Abdelghaffar-Elgendy/Furuta_Pendulum-/Simulink_Bodies/Submission/HIL_MCT411_T14/Actuating.png

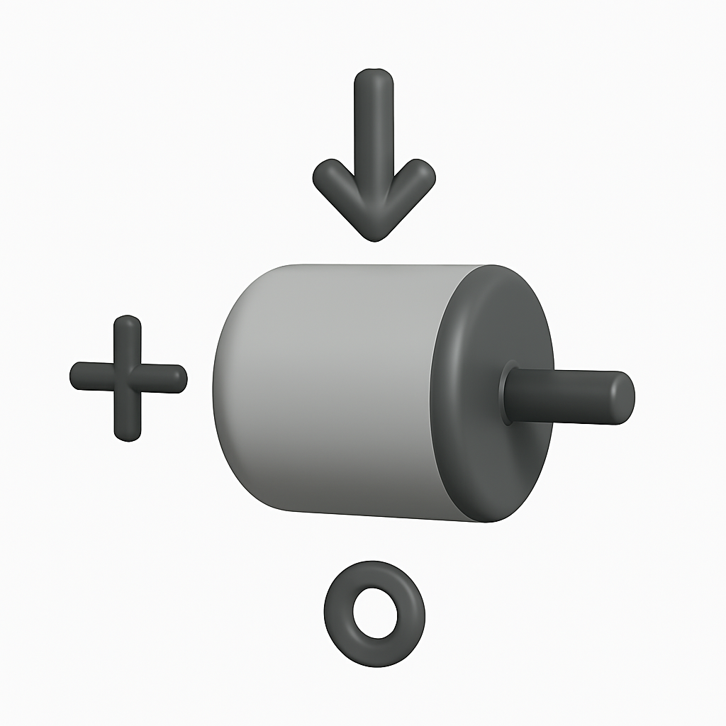
Simulink_Bodies/Submission/HIL_MCT411_T14/Actuating.png
