Abdelghaffar-Elgendy/Furuta_Pendulum-/Simulink_Bodies/Submission/CAD_T14_MCT411/Mini Rocker 4-Pin Switch.SLDPRT

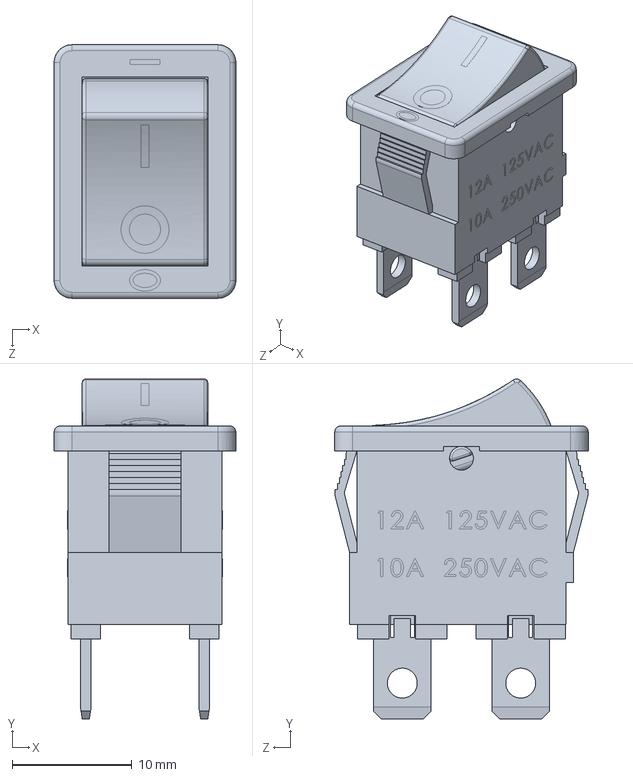
[picture p16: CAD file, 2025-12-24]
Simulink_Bodies/Submission/CAD_T14_MCT411/Mini Rocker 4-Pin Switch.SLDPRT
15.2 x 28.4 x 21.2 mm
