Abdelghaffar-Elgendy/Furuta_Pendulum-/Simulink_Bodies/Submission/Parameter_Estimation_T14/Bearing Holder_Default_sldprt.STEP

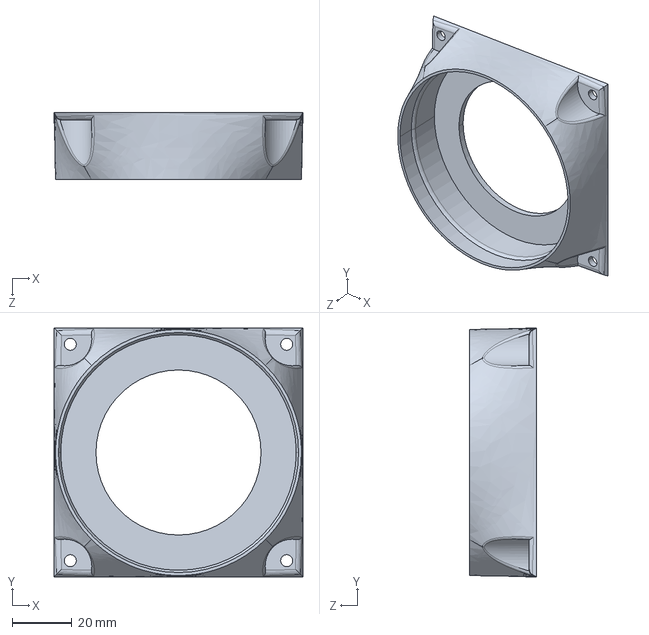
[picture p17: CAD file, 2025-12-14]
Simulink_Bodies/Submission/Parameter_Estimation_T14/Bearing Holder_Default_sldprt.STEP
83.0 x 83.0 x 22.5 mm
