Abdelghaffar-Elgendy/Furuta_Pendulum-/Simulink_Bodies/Submission/CAD_T14_MCT411/Box_sides.SLDPRT

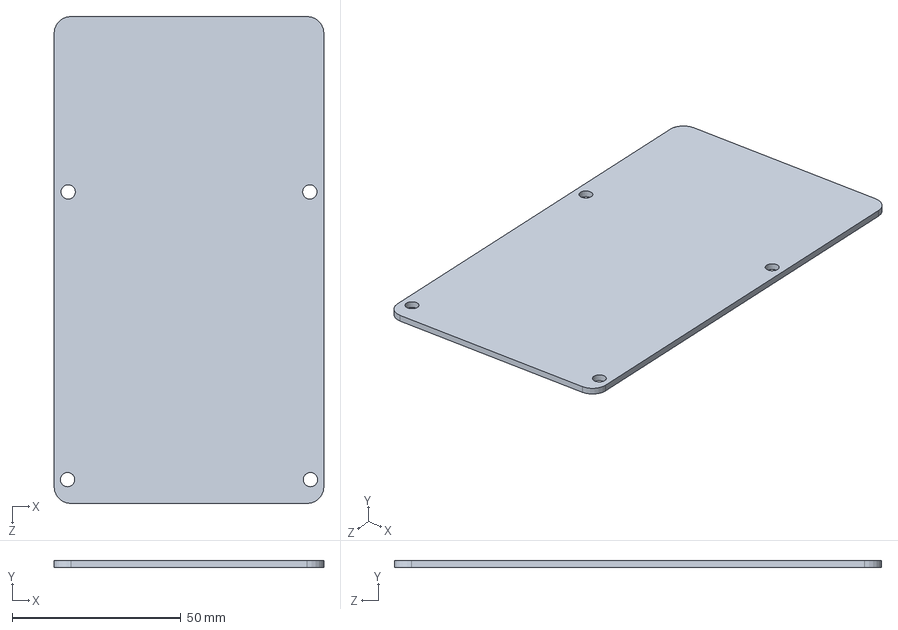
[picture p18: CAD file, 2025-12-24]
Simulink_Bodies/Submission/CAD_T14_MCT411/Box_sides.SLDPRT
80.0 x 2.00 x 144.4 mm
