Abdelghaffar-Elgendy/Furuta_Pendulum-/Simulink_Bodies/Submission/Parameter_Estimation_T14/Encoder Holder_Default_sldprt.STEP

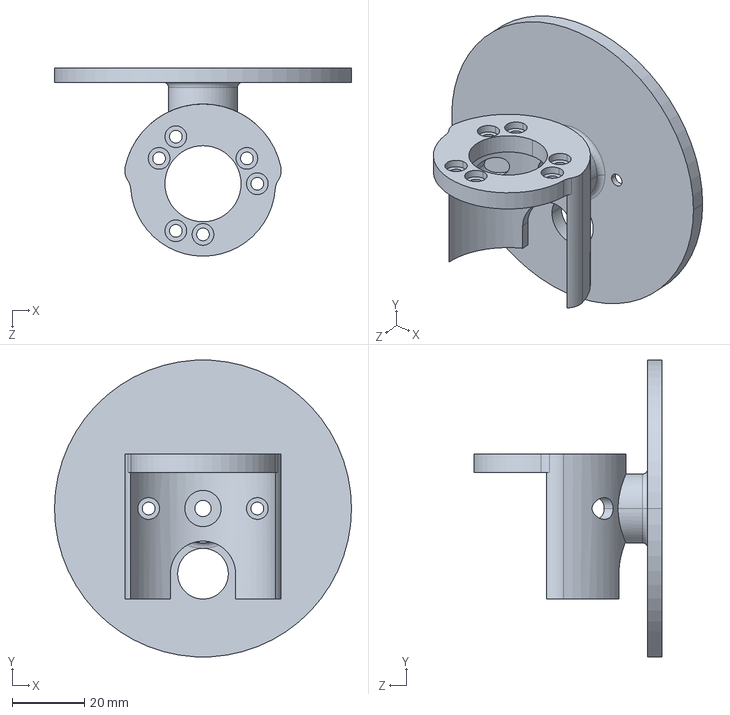
[picture p19: CAD file, 2025-12-14]
Simulink_Bodies/Submission/Parameter_Estimation_T14/Encoder Holder_Default_sldprt.STEP
82.0 x 81.9 x 52.0 mm
