Abdelghaffar-Elgendy/Furuta_Pendulum-/Simulink_Bodies/Submission/CAD_T14_MCT411/Coupler_ext.SLDPRT

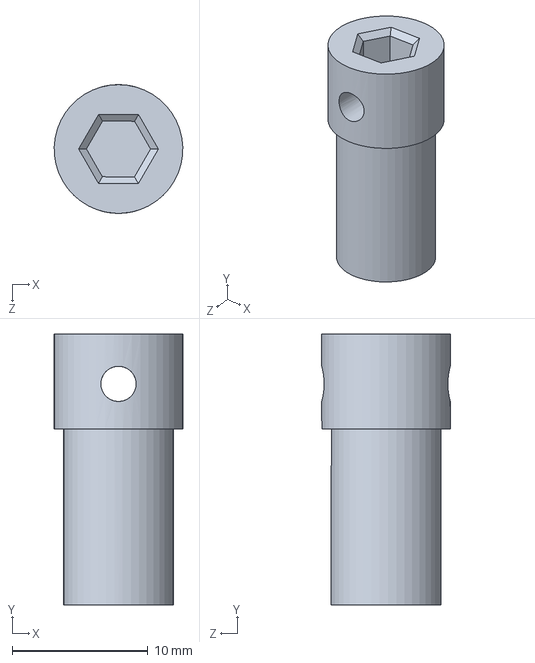
[picture p20: CAD file, 2025-12-24]
Simulink_Bodies/Submission/CAD_T14_MCT411/Coupler_ext.SLDPRT
9.49 x 20.0 x 9.50 mm
