Abdelghaffar-Elgendy/Furuta_Pendulum-/Simulink_Bodies/Submission/Parameter_Estimation_T14/coupler_Default_sldprt.STEP

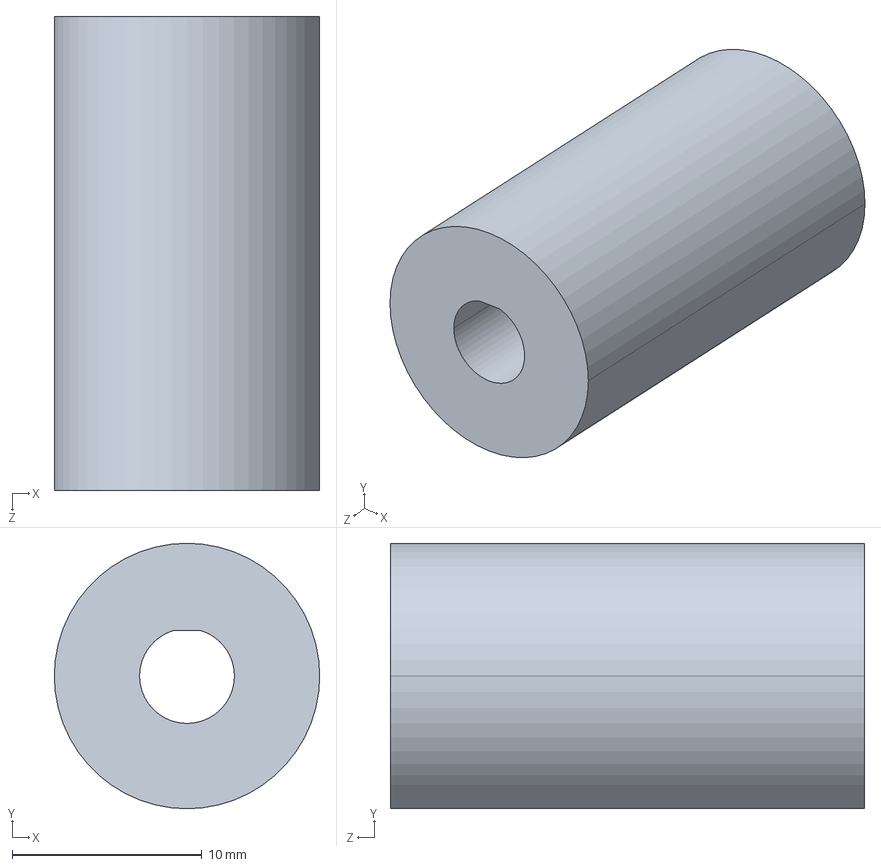
[picture p21: CAD file, 2025-12-14]
Simulink_Bodies/Submission/Parameter_Estimation_T14/coupler_Default_sldprt.STEP
14.0 x 14.0 x 25.0 mm
