Abdelghaffar-Elgendy/Furuta_Pendulum-/Simulink_Bodies/Submission/CAD_T14_MCT411/rod.SLDPRT

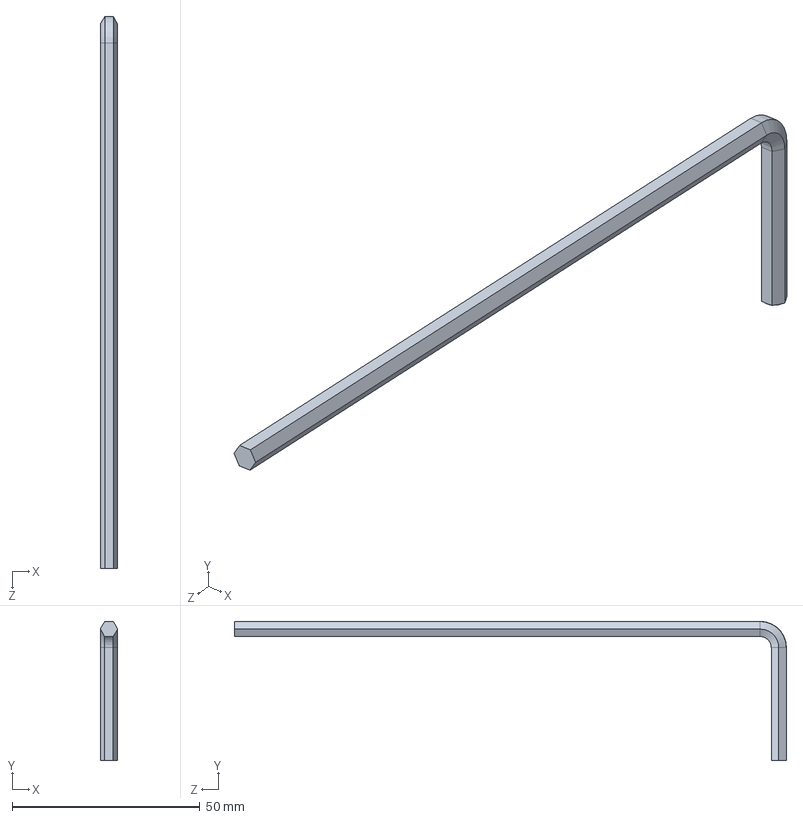
[picture p22: CAD file, 2025-12-24]
Simulink_Bodies/Submission/CAD_T14_MCT411/rod.SLDPRT
4.62 x 37.1 x 147.0 mm
