Abdelghaffar-Elgendy/Furuta_Pendulum-/Simulink_Bodies/Submission/Parameter_Estimation_T14/encoder_Default_sldprt.STEP

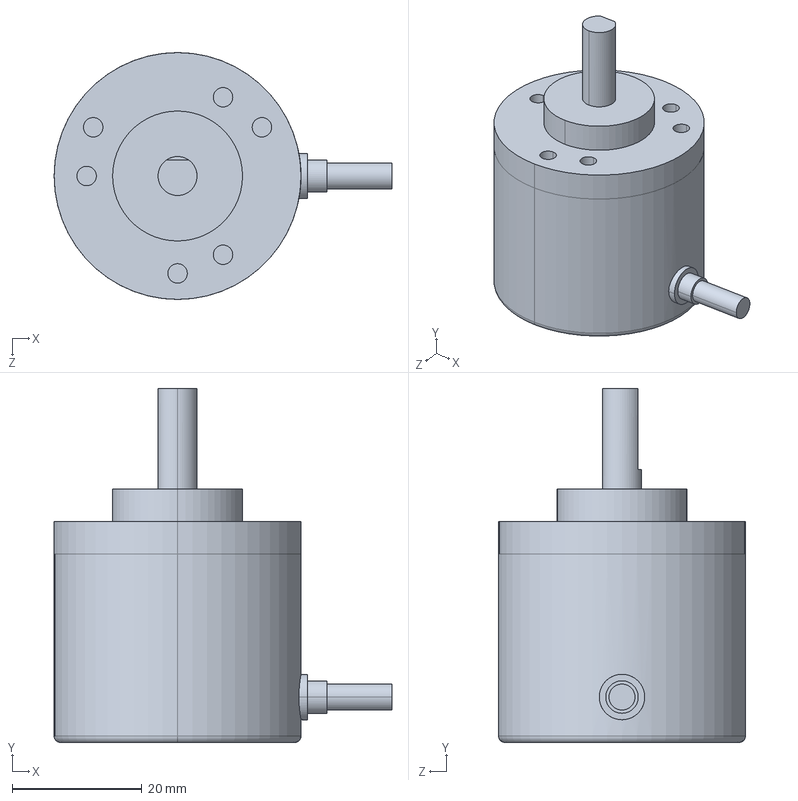
[picture p23: CAD file, 2025-12-14]
Simulink_Bodies/Submission/Parameter_Estimation_T14/encoder_Default_sldprt.STEP
52.0 x 54.5 x 38.0 mm
