Abdelghaffar-Elgendy/Furuta_Pendulum-/Simulink_Bodies/Submission/CAD_T14_MCT411/L298N Motor Driver.step

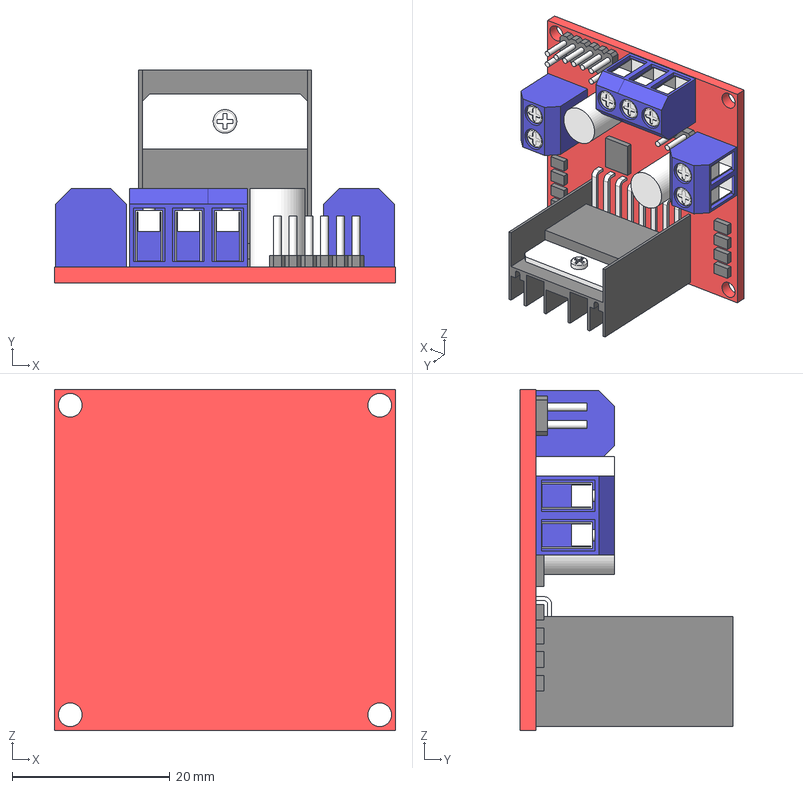
[picture p24: CAD file, 2025-12-24]
Simulink_Bodies/Submission/CAD_T14_MCT411/L298N Motor Driver.step
43.3 x 27.0 x 43.3 mm
Pcb
Pengunci x 2
Pengunci 2
