Abdelghaffar-Elgendy/Furuta_Pendulum-/Simulink_Bodies/Submission/Parameter_Estimation_T14/hexa_Default_sldprt.STEP

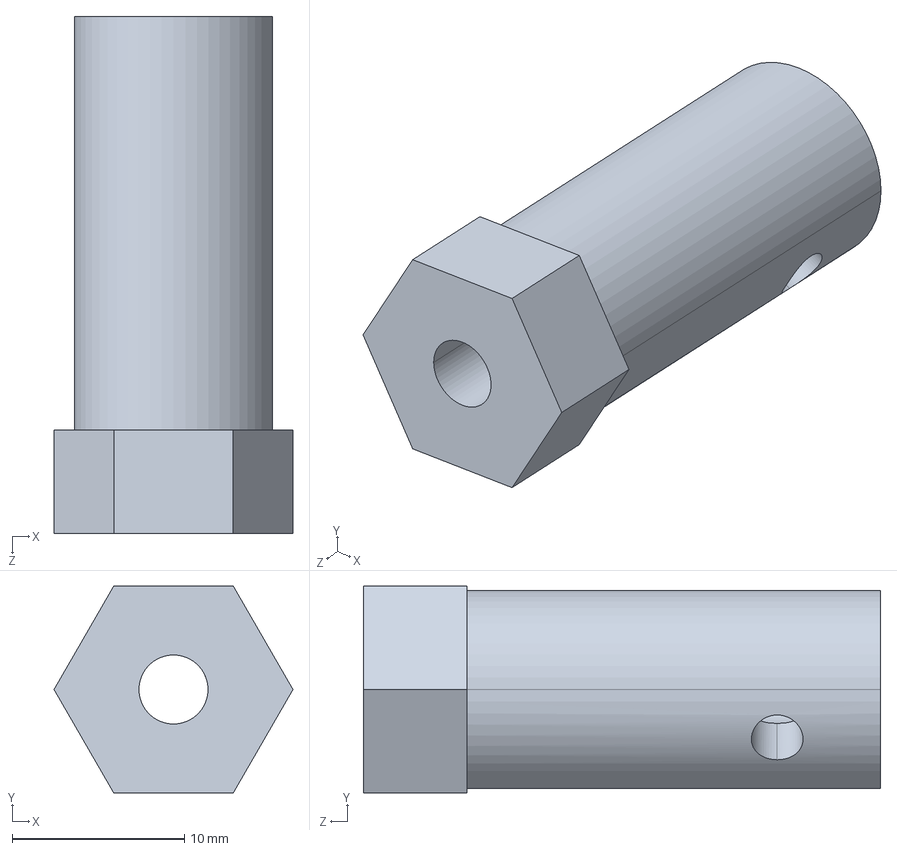
[picture p25: CAD file, 2025-12-14]
Simulink_Bodies/Submission/Parameter_Estimation_T14/hexa_Default_sldprt.STEP
13.9 x 12.0 x 30.0 mm
