Abdelghaffar-Elgendy/Furuta_Pendulum-/Simulink_Bodies/Submission/CAD_T14_MCT411/Bearing Holder.SLDPRT

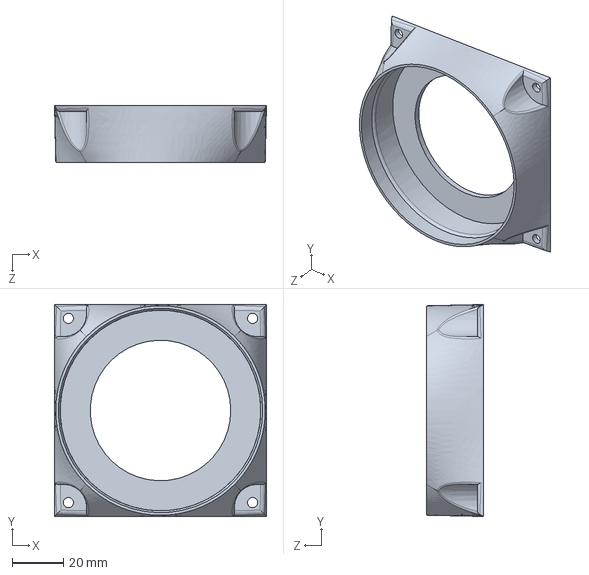
[picture p27: CAD file, 2025-12-24]
Simulink_Bodies/Submission/CAD_T14_MCT411/Bearing Holder.SLDPRT
83.0 x 83.0 x 22.5 mm
