Abdelghaffar-Elgendy/Furuta_Pendulum-/Simulink_Bodies/Submission/CAD_T14_MCT411/coupler.SLDPRT

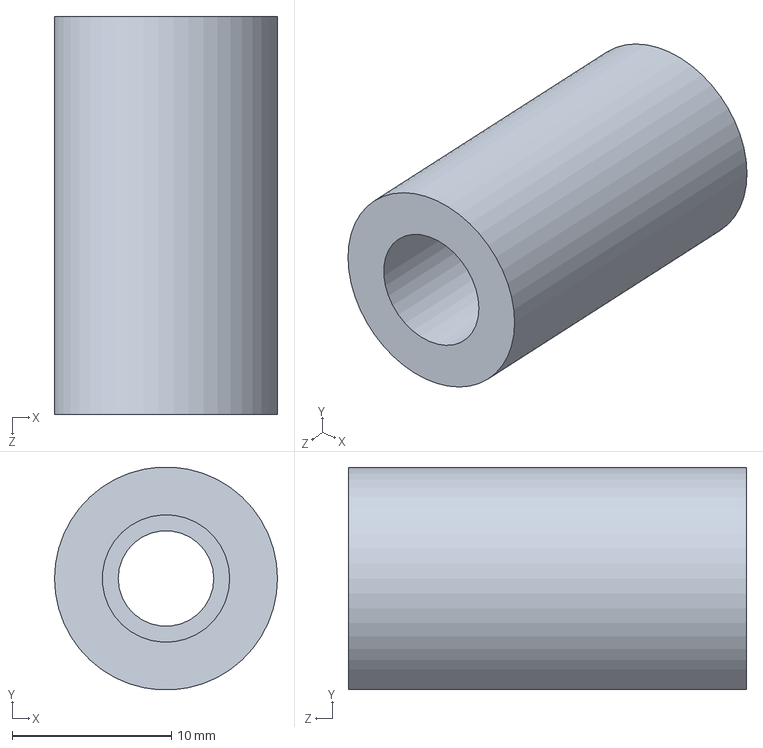
[picture p28: CAD file, 2025-12-24]
Simulink_Bodies/Submission/CAD_T14_MCT411/coupler.SLDPRT
14.0 x 14.0 x 25.0 mm
