Abdelghaffar-Elgendy/Furuta_Pendulum-/Simulink_Bodies/Submission/CAD_T14_MCT411/Motor_Bracket.SLDPRT

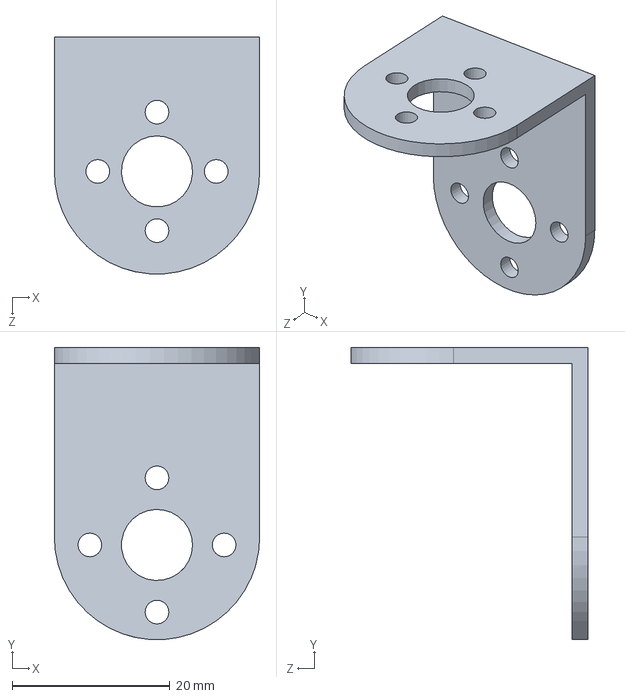
[picture p29: CAD file, 2025-12-12]
Simulink_Bodies/Submission/CAD_T14_MCT411/Motor_Bracket.SLDPRT
26.0 x 37.0 x 30.0 mm
