Abdelghaffar-Elgendy/Furuta_Pendulum-/Furuta_Project_Assembelly.SLDASM

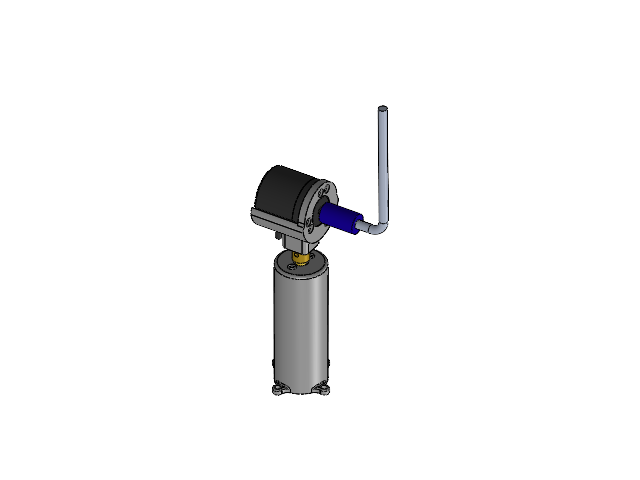
[picture p30: CAD file, 2025-11-23]
Furuta_Project_Assembelly.SLDASM
hexa
DCmotorr.stp
Motor Cover
coupler
Encoder Holder
rod
encoder.stp
