Abdelghaffar-Elgendy/Furuta_Pendulum-/(list of files, cad)

Other CAD files:
Simulink_Bodies/Submission/Parameter_Estimation_T14/rod_Default_sldprt.STEP
Simulink_Bodies/Submission/CAD_T14_MCT411/Encoder Holder.SLDPRT
Simulink_Bodies/Submission/CAD_T14_MCT411/hexa.SLDPRT
Simulink_Bodies/Submission/CAD_T14_MCT411/Box.SLDPRT
