Abdelghaffar-Elgendy/Furuta_Pendulum-/(commit log)

2025-11-23 Main Files, papacito
    [DCmotorr.stp, DCmotorr.stp_Default_sldprt.STEP, Encoder Holder.SLDPRT, Encoder Holder_Default_sldprt.STEP, Furuta_Project_Assembelly.SLDASM, Motor Cover.SLDPRT, Motor Cover_Default_sldprt.STEP, coupler.SLDPRT]
2025-12-02 New Files
    [Bearing Holder.SLDPRT, skf_bearing_51210_2.SLDASM, skf_bearing_51210_2_01.SLDPRT, skf_bearing_51210_2_02.SLDPRT, skf_bearing_51210_2_03.SLDPRT]
2025-12-12 Last Model
    [Bearing Holder.SLDPRT, Encoder Holder.SLDPRT, coupler.SLDPRT]
2025-12-12 Final Design
    [2352959.SLDPRT, 2352959_Default_sldprt.STEP, Bearing Holder_Default_sldprt.STEP, Box.SLDPRT, Box_Default_sldprt.STEP, Box_sides.SLDPRT, Encoder Holder_Default_sldprt.STEP, Furuta_Project_Assembelly.SLDASM]
2025-12-14 New hexa added
    [Bearing Holder_Default_sldprt.STEP, Box_Default_sldprt.STEP, Encoder Holder_Default_sldprt.STEP, coupler_Default_sldprt.STEP, encoder_Default_sldprt.STEP, hexa_Default_sldprt.STEP, rod_Default_sldprt.STEP]
2025-12-20 integration files
    [Bearing Holder_Default_sldprt.STEP, Box_Default_sldprt.STEP, Coupler_ext_Default_sldprt.STEP, Encoder Holder_Default_sldprt.STEP, coupler_Default_sldprt.STEP, encoder_Default_sldprt.STEP, hexa_Default_sldprt.STEP, rod_Default_sldprt.STEP]
2025-12-23 edit: final files
    [Bearing Holder_Default_sldprt.STEP, Box_Default_sldprt.STEP, Coupler_ext_Default_sldprt.STEP, Encoder Holder_Default_sldprt.STEP, coupler_Default_sldprt.STEP, encoder_Default_sldprt.STEP, hexa_Default_sldprt.STEP, rod_Default_sldprt.STEP]
2025-12-24 added parameter estimation files
    [Bearing Holder_Default_sldprt.STEP, Box_Default_sldprt.STEP, Encoder Holder_Default_sldprt.STEP, coupler_Default_sldprt.STEP, encoder_Default_sldprt.STEP, hexa_Default_sldprt.STEP, rod_Default_sldprt.STEP]
2025-12-24 deleted unneccessary files
    [2352959.SLDPRT, 2352959_Default_sldprt.STEP, Bearing Holder.SLDPRT, Bearing Holder_Default_sldprt.STEP, Box.SLDPRT, Box_Default_sldprt.STEP, Box_sides.SLDPRT, Coupler_ext_Default_sldprt.STEP]
2025-12-24 added CAD files
    [Bearing Holder.SLDPRT, Box.SLDPRT, Box_sides.SLDPRT, Coupler_ext.SLDPRT, Encoder Holder.SLDPRT, L298N Motor Driver.step, Mini Rocker 4-Pin Switch.SLDPRT, Motor_Bracket.SLDPRT]
2025-12-24 deleted old files
    [Furuta_Project_Assembelly.SLDASM, skf_bearing_51210_2.SLDASM, skf_bearing_51210_2_01.SLDPRT, skf_bearing_51210_2_02.SLDPRT, skf_bearing_51210_2_03.SLDPRT]
